LukaRic7/Electric-Model-Train/README.md

# School UP-el general test project

Read the [report](/ElektriskTog.pdf) for full information.
