LukaRic7/Electric-Model-Train/(commit log)

2026-01-31 Change wireless transmit pin from 1 to 12
    Updated the pin assignment for the wireless transmission.
2026-01-31 Remove transmitter receive pin and setup
    Removed transmitter receive pin definition and its pinMode setup.
2026-01-31 Add transmitter pin documentation to TrainDriver.ino
2026-03-11 Add initial README for School UP-el project
